eYSIP-2017/eYSIP-2017_Development-of-Tiva-based-daughter-board-for-FireBird/readme.txt

This folder contains the work done on Tiva based daughter board.
It includes manuals, experiment codes, schematics, report etc.
