eYSIP-2017/eYSIP-2017_Development-of-Tiva-based-daughter-board-for-FireBird/Schematic/Version 2/Readme.txt

The version 2 of uC based board is not routed. The sechmatic is changed as per requirement. The components are placed in their respective postions. 
Only the routing part is left.

The version 2 of Plug and Play board is fully completed.
