eYSIP-2017/eYSIP-2017_Development-of-Tiva-based-daughter-board-for-FireBird/report_eYSIP/report_eYSIP.pdf

## eYSIP2017

### Tiva Based Daughter Board

For Firebird V.

### Ayush Gaurav

Nagesh K.

### Piyush Manavar Saurav Shandilya Duration of Internship: 22/05/2017 − 07/07/2017

2017, e-Yantra Publication

# Tiva Based Daughter Board For

Firebird V.

## Abstract

The objective of the project was to design two daughter boards for firebird V which has following features:

- Compatible With TIVA based platform.
- must support all the necessary features of firebird.

The deliverables expected were

- 2 working daughter boards one with tiva launch pad and another with the Tiva TM4C123GH6PM.
- Hardware and software manual for anyone using it in future.
- All the demo codes for assistance.

### Completion status

The project was divided in many small tasks which were to be completed in given time. Though we refrain from mentioning that long list but still will give some important one.

- Learning Tiva Platform.
- Finding solution for limitations offered by Tiva, like limited GPIO pins and limited ADC channels.
- Utilizing the functionality provided to the maximum.
- Creating schematic and layout for the daughter boards.

1

1.1. HARDWARE PARTS
- Testing the boards and writing all the test codes.
- Making hardware and software manuals.

## 1.1 Hardware parts

- List of hardware used :

– Tiva launchpad.

– TM4C123GH6PM.

– MCP23017 port expander.

– ADC128D818 external adc.

– Voltage regulator(lm1117,7805).

- Detail of each hardware:
1. Tiva Launchpad: It is a micro-controller board by Texas Instruments that has on board programmer with real time debugger feature. The micro-controller is very efficient with system clock up to 80MHz and CAN protocol. The tutorial and more information can be read from Datasheet,,
2. TM4C123GH6PM is a ARM cortex M4 based micro-controller that is used as a controller of the Tiva Launchpad. You can read Datasheet for more details.
3. Voltage Regulators:The voltage source available on the Firebird is 9.6V. But the TIVA platform works on 3.3V and the servos can operate upto 6V. So there must be 3 different voltage levels on the board. The uC based board has 2 voltage regulators and the plug and play board has 1 voltage regulator. In the uC based board the 9.6 volts is regulated 3.3V to power the micro-controller. In the plug and play board the there is an inbuilt voltage regulator, so it is directly connected connected to 5v, 300mA source. The servo in both the boards has a separate 5V regulator. Datasheets for3.3 volts regulator lm1117, and 5 volts regulator 7805 5 volts regulator can be accessed from the links,
4. Level Converters TIVA platform operates at 3.3V and the Firebird operates at 5V. Directly connecting these pins to the TIVA may be fatal. So to for proper level maintenance, a level converter is used. A bidirectional MOS- FET based level converter used.
www.e-yantra.org | 2

1.2. SOFTWARE USED

The level converter is necessary is for input pins. In the boards Level converter is used for interfacing the position encoders of the motors. Datasheet of MOSFET is also provided.

5. Port Expander(MCP23017):TM4C123GH6PM has only 64 pins out which only 43 are GPIO pins. This limits our application to read input and respond correspondingly. To increase the number of GPIO and there interrupts we have used I2C compatible a port expander MCP23017. It has 2 PORTS A and B, with each port having 8 Pins.The interrupts on each pin can also be monitored. To read more about it, download the datasheet from here.The schematic of the connection is shown below.Keep in mind that I2C SCL and SDA have already been pulled up using 10K resistor.Datasheet of the port expander can be fount here.
- Connection diagram

## 1.2 Software used

- Code Composer Studio
- Detail of software: version, 7.1.0 download link, (http://processors.wiki.ti.com/index.php/Download_CCS)
- Installation steps

## 1.3 Assembly of hardware

Circuit diagram and m,¿Steps of assembly of hardware with pictures for each step

### Circuit Diagram

Circuit schematic, simplified circuit diagram , block diagram of system

### Step 1

Steps for assembling part 1

### Step 2

Steps for assembling part 2

www.e-yantra.org | 3

1.4. SOFTWARE AND CODE

### Step 3

Steps for assembling part 3

## 1.4 Software and Code

Github link (http://www.github.com) for the repository of code
Brief explanation of various parts of code

## 1.5 Use and Demo

Final Setup Image
User Instruction for demonstration Youtube Link (http://www.youtube.com) of demonstration video

## 1.6 Future Work

What can be done to take this work ahead in future as projects.

## 1.7 Bug report and Challenges

Any issues in code and hardware.
Any failure or challenges faced during project
www.e-yantra.org | 4

# Bibliography

[1] Ad Kamerman and Leo Monteban, WaveLAN-II: A High-Performance Wireless LAN for the Unlicensed band, 1997.

5
