eYSIP-2017/eYSIP-2017_Development-of-Tiva-based-daughter-board-for-FireBird/Documents/Progress Presentation I/Progress-Presentation.pdf

Overview of Project Overview of Task Overview of Task Task Accomplised Pin Assignment Pin Assignment Pin Assignment Pin Assignment Schematic Schematic Layout Layout Challenges Faced Future Plans Thank You

# Progress Presentation-I

# e-Yantra Summer Intership-2016 Tiva based Daughter Board For Firebird V

# Ayush Gaurav Nagesh K Mentors: Piyush Manavar Saurav Shandilya

## IIT Bombay

# June 9, 2017

Ayush Gaurav Nagesh K Mentors: Piyush Manavar Saurav Shandilya | IIT Bombay

Progress Presentation-I

# Overview of Project

Project Name: Tiva based Daughter Board For Firebird V.

# Objective: To design and develop a daughter board for firebird V with the following criterion:

1 | Tiva Based Platform.
2 | On board Programing facility.
3 | Direct compatibility to Firebird.

# Deliverables:

1 | Final schematic.
| Launchpad based daughter board TM4C123GH6PM based daughter board
2 | Working daughter board.
3 | Working codes for I/O, PWM, position encoders, lcd, wired and
| wireless communication, ADC.

# Overview of Task

Task | Deadline | Status
Understaing daughter board. List the pins of daughter board. Familiarize with Tiva C series Launchpad. | 3 days | Completed
Finalize the platform to design | 3 days | Completed
Design the schematic. Check compatibality with Firebird. | 2 days | Completed

# Overview of Task

Task | Deadline | Status
Discuss and add the necessary features to achieve maximum functionality. | 3 days | completed
Finalize the schematic. | 1 day | completed

# Task Accomplised

# Familiarization with Tiva Launchpad. Interfaced the following:

# GPIO

Timers and its interrupts.
External interrupts.
Pulse Width Modulation.
UART and its interrupts.

# Wired and wireless

Analog to digital converter.
LCD.
Studied the circuits to run the micro-controller. Analyzing the pins of firebird.
Assigning the pins of uC.
designing the schematics.

# Pin Assignment of uC based board


# Pin Assignment of uC based board


# Pin Assignment of launchpad based board

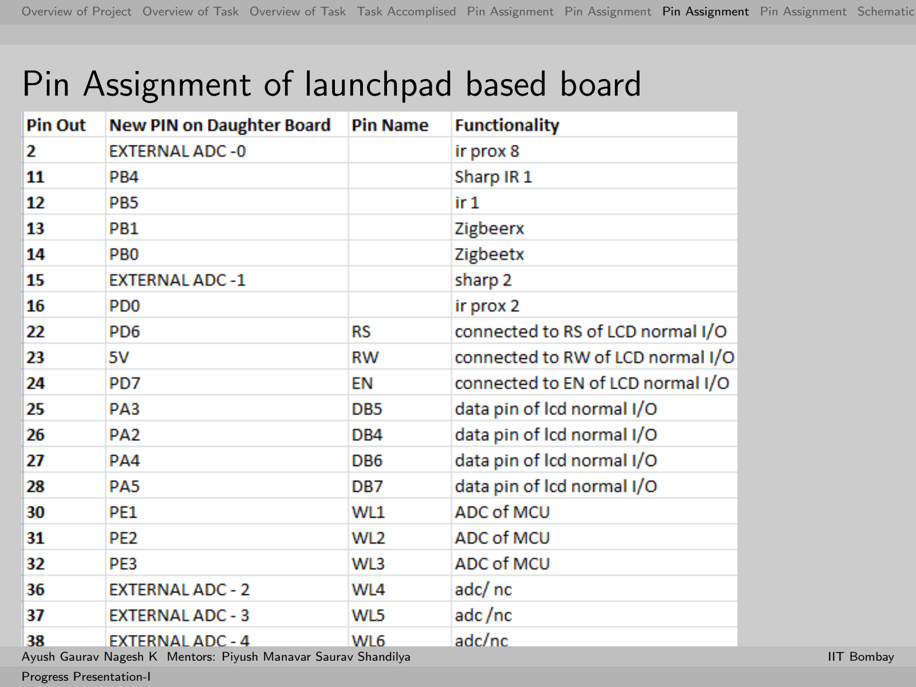
[picture p35: page 8]

# Pin Assignment of launchpad based board


# Schematic of uC based board


# Schematic of launchpad based board


# Layout of launchpad based board

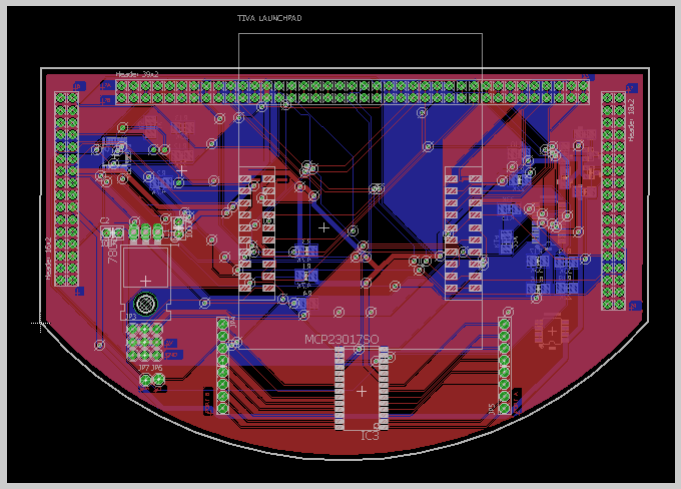
[picture p36: figure]

# Layout of uC based board


# Challenges Faced

Voltage incompatibility.
Pin availability.

# number of sensors on firebird

Nonavailability of firmware to program the board. Interfacing 5V compatible sensors with 3.3V compatible uC. Separate power supply for servo motors.

# Future Plans

Working Daughter board in next 2 weeks.
All the working codes.
Proper hardware manual by the end of the internship period.

# Thank You

# THANK YOU !!!
