eYSIP-2017/eYSIP-2017_Development-of-Tiva-based-daughter-board-for-FireBird/Sheet/schematic 2.xlsx

PA | PB |  | PC | PD | PE | PF
2 | 4 |  | 4 | 0 | 1 | 2
3 | 5 |  | 5 | 1 | 2 | 3
4 | 1 |  | 6 | 2 | 3 | 0 |  | free pins
5 | 0 |  |  | 3 | 4 | 1
6 | 3 |  |  |  | 5 | 4 |  | PF1 | SERVO
7 |  |  |  |  | 0 |  |  | PB6 | SERVO
 |  |  |  |  |  |  |  | PB7 | SERVO
 |  |  |  |  |  |  |  | PC7 | Interrupt for port expander
PA | PB |  | PC | PD | PE | PF |  | PA6 | I2C
2 | 0 |  | 4 | 0 | 0 | 0 |  | PA7 | I2C
3 | 1 |  | 5 | 1 | 1 | 1
4 | 3 |  | 6 | 2 | 2 | 2
5 | 4 |  |  | 3 | 3 | 3
6 | 5 |  |  |  | 4 | 4
7 |  |  |  |  | 5
 |  |  |  |  |  |  | channel | EXTERNAL ADC
 |  |  |  |  |  |  | 0 | ir prox 8
Connections: |  |  |  |  |  |  | 1 | sharp 2
1 | No |  | Current sensor |  |  |  | 2 | WL4
2 | EXTERNAL ADC -0 |  | ir prox 8 |  |  |  | 3 | WL5
3 |  |  | ground |  |  |  | 4 | WL6
4 | will use the inbuilt micro USB |  | DATA+ |  |  |  | 5 | WL7
5 | will use the inbuilt micro USB |  | DATA- |  |  |  | 6 | sharp sensor 4
6 |  |  | VCC USB |  |  |  | 7 | IR Prox6
7 |  |  | 5V(400mA)
8 |  |  | 5v 300mA
9 |  |  | 5v 300mA
10 |  |  | 5v 400ma
11 | PB4 |  | Sharp IR 1
12 | PB5 |  | ir 1
13 | PB1 |  | Zigbeerx
14 | PB0 |  | Zigbeetx
15 | EXTERNAL ADC -1 |  | sharp 2
16 | PD0 |  | ir prox 2
17 |  | RSSI | Connected to interrupt, Receive Strengh Signal, Can Measure Distance(DOUBTFUL an led)
18 |  | MOSI | MOSI of the Controller/NC create extra expansion headers
19 |  | MISO | MISO of controller/NC create extra expansion headers
20 |  | SCK | SCK of the controller/NC create extra expansion headers
21 |  | SSI | SS of the controller/ NC create extra expansion headers
22 | PD6 | RS | connected to RS of LCD normal I/O
23 | GND | RW | connected to RW of LCD normal I/O
24 | PD7 | EN | connected to EN of LCD normal I/O
25 | PA3 | DB5 | data pin of lcd normal I/O
26 | PA2 | DB4 | data pin of lcd normal I/O
27 | PA4 | DB6 | data pin of lcd normal I/O
28 | PA5 | DB7 | data pin of lcd normal I/O
29 |  | V Battery System | ADC to check the level of battery voltage
30 | PE1 | WL1 | ADC of MCU
31 | PE2 | WL2 | ADC of MCU
32 | PE3 | WL3 | ADC of MCU
33
34
35 |  | 5V
36 | EXTERNAL ADC - 2 | WL4 | adc/ nc
37 | EXTERNAL ADC - 3 | WL5 | adc /nc
38 | EXTERNAL ADC - 4 | WL6 | adc/nc
39 | EXTERNAL ADC - 5 | WL7 | adc/nc
40
41 | PD2 | Sharp Sensor 3 | ADC
42 | PD3 | IR prox 3 | ADC
43 | PD1 | IR prox 4 | ADC
44 | EXTERNAL ADC - 6 | sharp sensor 4 | ADC
45 | PE4 | sharp sensor 5 | ADC
46 | PE5 | ir prox 5 | ADC
47 |  | C11 motor | not present
48 |  | C1 PWM | not present
49 |  | c12 | not present
50 | PF2 | PWM L | left motor PWM(timer pin in PWM mode)
51 | PF3 | L1 | left motor pin1 normal I/O
52 | PB3 | L2 | left motor pin2 normal I/O
53 | PC4 | R1 | right motor pin1 normal I/O
54 | PC5 | PWM R2 | right motor PWM(timer pin in PWM mode)
55 | PC6 | R2 | right motor pin2
56 |  | NC
57 |  | NC
58 |  | NC
59 |  | NC
60 |  | NC
61 |  | NC
62 | PB2 | Position encoder left | int
63 | PF0 | Position encoder right | int
64 |  | position enocder C2 | int NC
65 |  | Position encoder C1 | int NC
66 |  | C22 | NC
67 |  | C21 | NC
68 |  | C2Pwm | NC
69 | EXTERNAL ADC - 7 | IR Prox6 | ADC
70 | PE0 | IR Prox7 | ADC
71 | PF4 | Buzzer | normal I/O pin
72 |  | DAC Out | NC
73 |  | RS232 TX | TX of UART
74 |  | RS232 RX | RX of UART
