eYSIP-2017/eYSIP-2017_Development-of-Tiva-based-daughter-board-for-FireBird/Daughter Board Manual/Hardware/Images/3v3Sensors.PNG

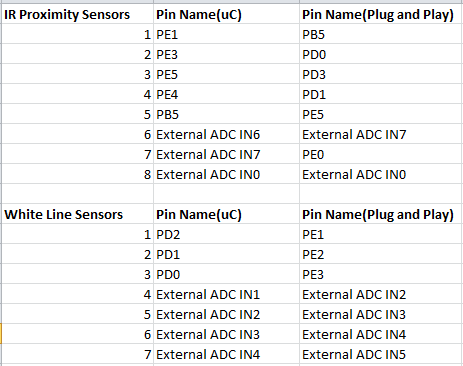
Daughter Board Manual/Hardware/Images/3v3Sensors.PNG
