eYSIP-2017/eYSIP-2017_Development-of-Tiva-based-daughter-board-for-FireBird/Daughter Board Manual/Hardware/Images/ADC.PNG

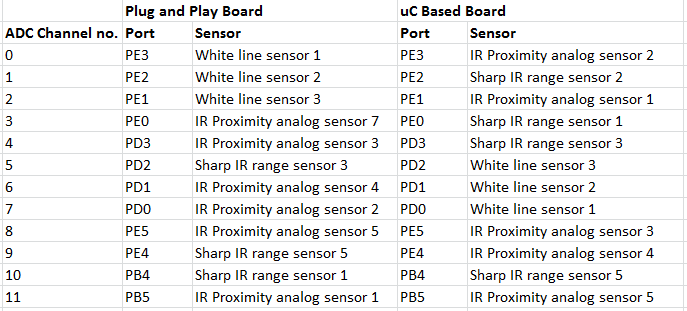
Daughter Board Manual/Hardware/Images/ADC.PNG
