eYSIP-2017/eYSIP-2017_Development-of-Tiva-based-daughter-board-for-FireBird/Documents/Poster/TIVA.png

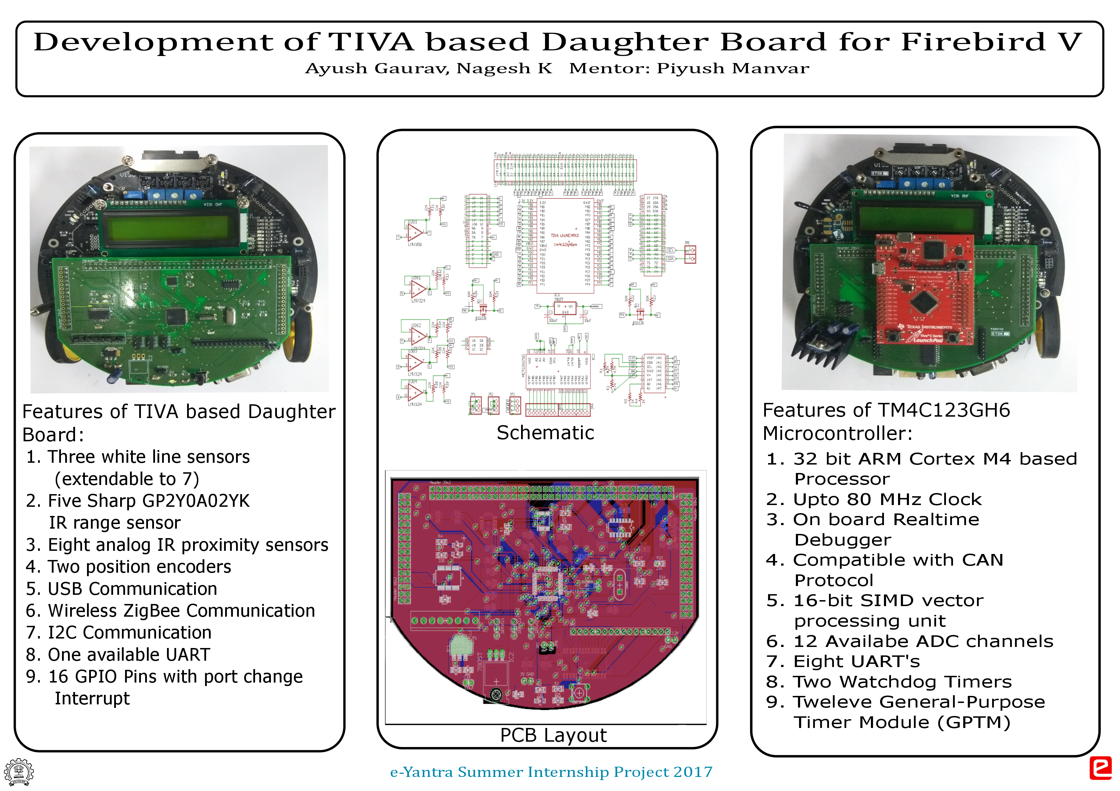
Documents/Poster/TIVA.png
