eYSIP-2017/eYSIP-2017_Development-of-Tiva-based-daughter-board-for-FireBird/report_eYSIP/Images/E4.PNG

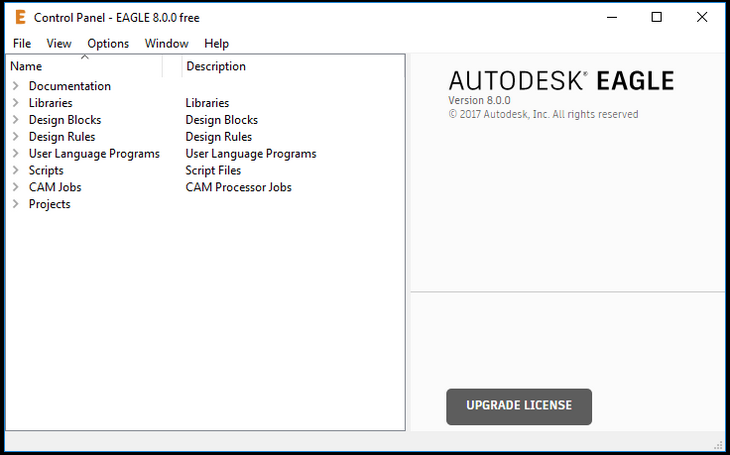
report_eYSIP/Images/E4.PNG
