eYSIP-2017/eYSIP-2017_Development-of-Tiva-based-daughter-board-for-FireBird/Daughter Board Manual/readme.txt

This folder contains hardware and software manual for daughter board.
