eYSIP-2017/eYSIP-2017_Development-of-Tiva-based-daughter-board-for-FireBird/Experiment/Plug And Play/Readme.txt

This folder contains example codes for Plug and Play Board.

All these codes are compiled in Code Composer Studio version 7.1.0 on Windows 10 Operating System.
