eYSIP-2017/eYSIP-2017_Development-of-Tiva-based-daughter-board-for-FireBird/Experiment/uC Based/Readme.txt

This folder contains example codes for uC based Board.

All these codes are compiled in Code Composer Studio version 7.1.0 on Windows 10 Operating System.
