eYSIP-2017/eYSIP-2017_Development-of-Tiva-based-daughter-board-for-FireBird/Schematic/Version 2/Uc/uC.brd

## EAGLE design Schematic/Version 2/Uc/uC.brd (2017-07-04)

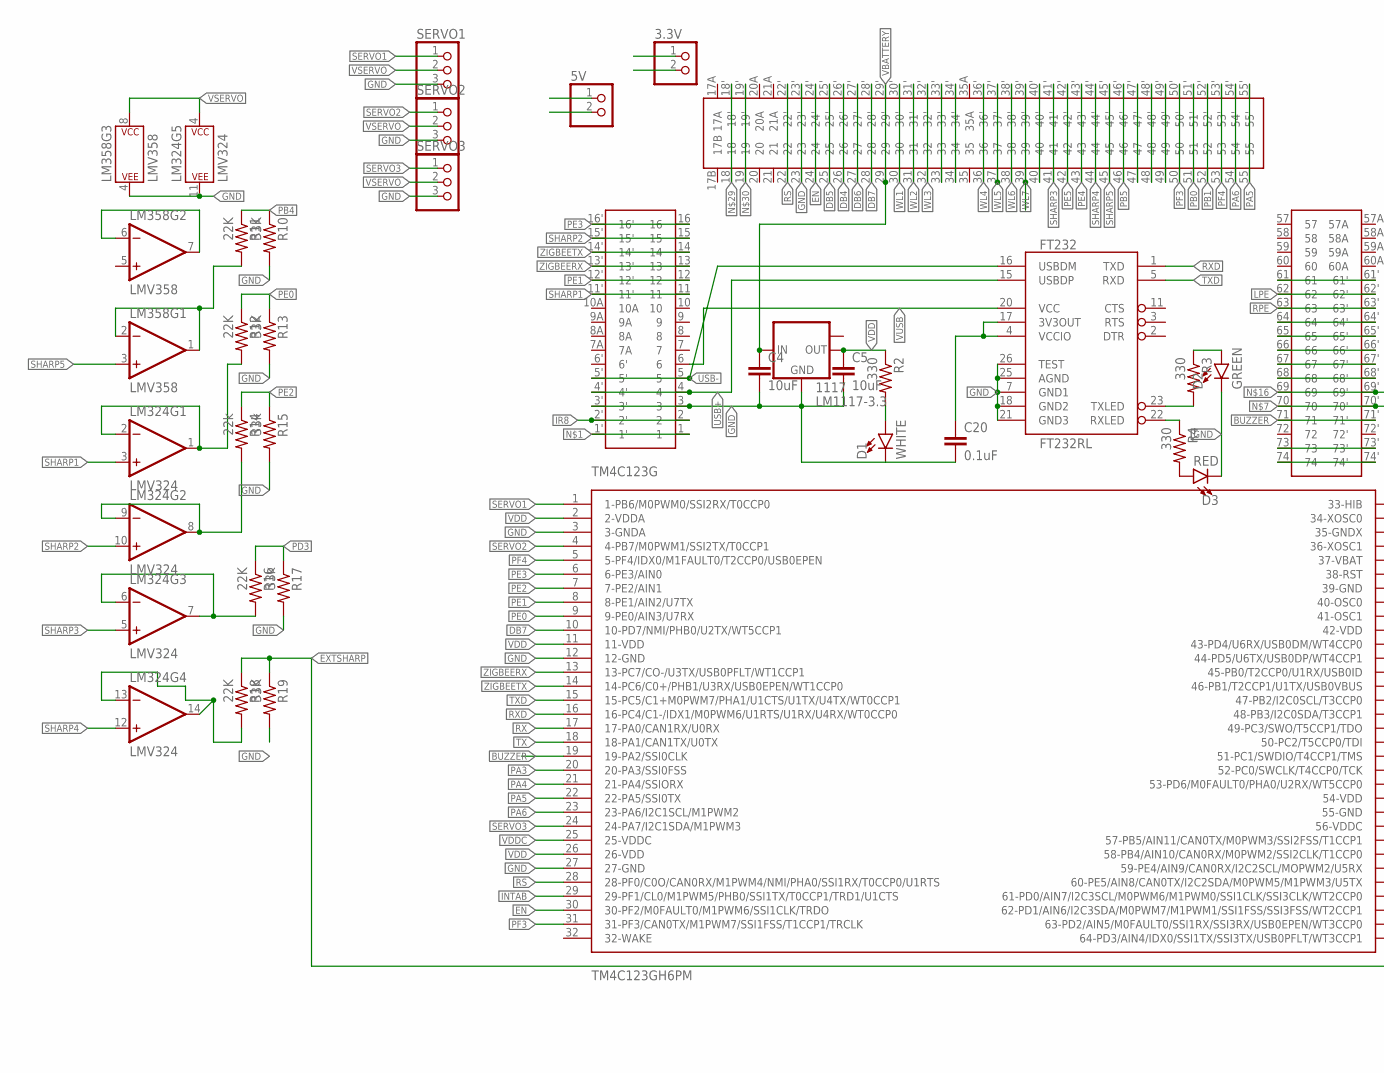
[picture p80: schematic uC.sch, part in row 1, column 1]

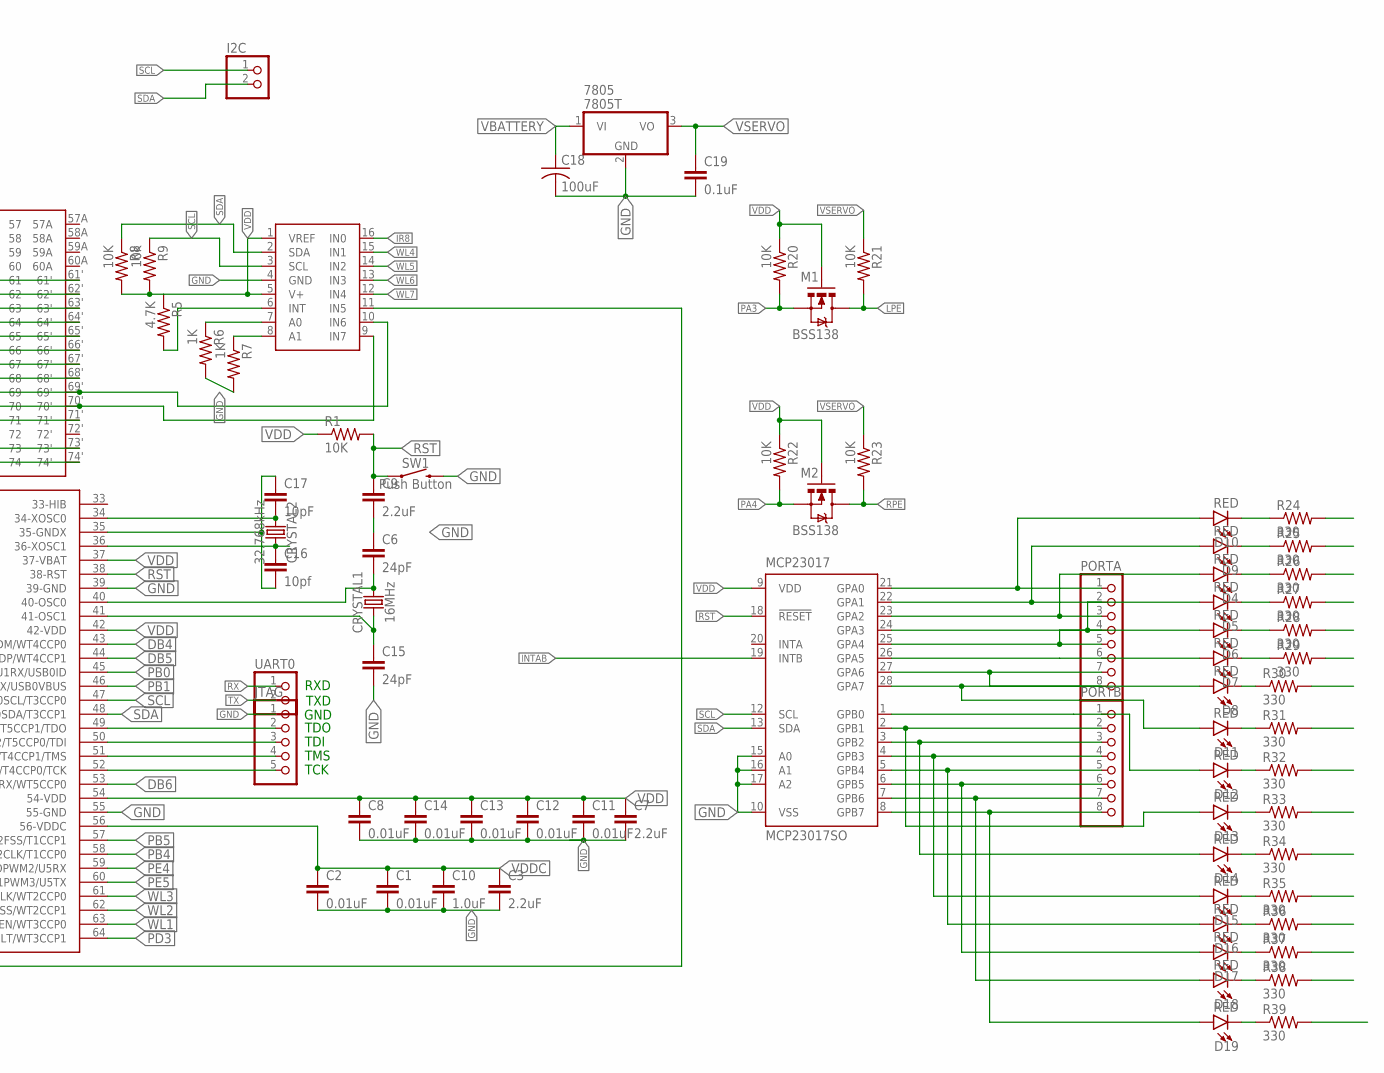
[picture p81: schematic uC.sch, part in row 1, column 2]

Parts:
3.3V, 5V: PINHD-1X2; 1X02
1117: LM1117-3.3; SOT223
7805: 7805T; TO220H
ADC128D818: ADC128D818; ADC12_SD
C1, C2, C8, C11, C12, C13, C14: 0.01uF; 1206
C3, C7, C9: 2.2uF; 1206
C4, C5: 10uF; 1206
C6, C15: 24pF; 1206
C10: 1.0uF; 1206
C16: 10pf; 1206
C17: 10pF; 1206
C18: 100uF; C025-024X044
C19, C20: 0.1uF; 1206
CRYSTAL1: 16MHz; HC49US
CRYSTAL2: 32.768kHz; CRYSTAL-PTH-2X6-CYL
D1: WHITE; LED-1206
D2: GREEN; LED-1206
D3, D4, D5, D6, D7, D8, D9, D10, D11, D12, D13, D14, D15, D16, D17, D18, D19: RED; LED-1206
FT232: FT232RL; SSOP28DB
I2C: PINHD-1X2; 1X02
JTAG: PINHD-1X5_2.54; 1X05
LM324: LMV324; SO14
LM358: LMV358; SO08
M1, M2: BSS138; SOT23-3
MCP23017: MCP23017SO; SO28W
PORTA: PINHD-1X8BIG; 1X08-BIG
PORTB: PINHD-1X8BIG; 1X08-BIG
R1, R8: 10K; M1206
R2, R3, R4, R24, R25, R26, R27, R28, R29, R30, R31, R32, R33, R34, R35, R36, R37, R38, R39: 330; M1206
R5: 4.7K; M1206
R6, R7: 1K; M1206
R9: 10k; M1206
R10, R13, R19: 33K; M1206
R11, R12, R16, R18: 22K; M1206
R14: 22k; M1206
R15, R17: 33k; M1206
R20, R21, R22, R23: 10K; 1206
SERVO1, SERVO2, SERVO3: PINHD-1X3; 1X03
SW1: Push Button; TACTILE_SWITCH_PTH_6.0MM
TM4C123G: TM4C123GH6PM; LQFP
U$1: DAUGHTERBOARDDAUGHTERBOARD; DAUGHTERBOARD
UART0: PINHD-1X2; 1X02

Connections:
BUZZER: TM4C123G.19 (19-PA2/SSI0CLK), U$1.71, U$1.71'
DB4: TM4C123G.43 (43-PD4/U6RX/USB0DM/WT4CCP0), U$1.26, U$1.26'
DB5: TM4C123G.44 (44-PD5/U6TX/USB0DP/WT4CCP1), U$1.25, U$1.25'
DB6: TM4C123G.53 (53-PD6/M0FAULT0/PHA0/U2RX/WT5CCP0), U$1.27, U$1.27'
DB7: TM4C123G.10 (10-PD7/NMI/PHB0/U2TX/WT5CCP1), U$1.28, U$1.28'
EN: TM4C123G.30 (30-PF2/M0FAULT0/M1PWM6/SSI1CLK/TRDO), U$1.24, U$1.24'
EXTSHARP: ADC128D818.11 (IN5), R18.1, R19.1
FDSFSDF: LM324.1 (OUT), LM324.2 (-IN), R12.2
GND: 3.3V.2, 5V.2, 1117.1 (GND), 7805.2 (GND), ADC128D818.4 (GND), C1.2, C2.2, C3.2, C4.2, C5.2, C6.1, C7.2, C8.2, C9.2, C10.2, C11.2, C12.2, C13.2, C14.2, C15.2, C18.2, C19.2, C20.2, D1.C, D2.C, D3.C, FT232.7 (GND1), FT232.18 (GND2), FT232.21 (GND3), FT232.25 (AGND), FT232.26 (TEST), JTAG.1, LM324.11 (P$V-), LM358.4 (P$V-), MCP23017.10 (VSS), MCP23017.15 (A0), MCP23017.16 (A1), MCP23017.17 (A2), R6.2, R7.2, R10.2, R13.2, R15.2, R17.2, R19.2, R24.2, R25.2, R26.2, R27.2, R28.2, R29.2, R30.2, R31.2, R32.2, R33.2, R34.2, R35.2, R36.2, R37.2, R38.2, R39.2, SERVO1.3, SERVO2.3, SERVO3.3, SW1.3 (2), TM4C123G.3 (3-GNDA), TM4C123G.12 (12-GND), TM4C123G.27 (27-GND), TM4C123G.39 (39-GND), TM4C123G.55 (55-GND), U$1.3, U$1.3', U$1.23, U$1.23'
GNDX: C16.2, C17.1, TM4C123G.35 (35-GNDX)
HGHJ: LM358.1 (OUT), LM358.2 (-IN), R11.2
INTAB: MCP23017.19 (INTB), TM4C123G.29 (29-PF1/CL0/M1PWM5/PHB0/SSI1TX/T0CCP1/TR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)
IR8: ADC128D818.16 (IN0), U$1.2, U$1.2'
LPE: M1.3 (D), R21.2, U$1.62, U$1.62'
unnamed: U$1.1, U$1.1'
unnamed: D10.A, MCP23017.21 (GPA0), PORTA.1
unnamed: C6.2, CRYSTAL1.2, TM4C123G.40 (40-OSC0)
unnamed: D9.A, MCP23017.22 (GPA1), PORTA.2
unnamed: LM358.6 (-IN), LM358.7 (OUT)
unnamed: ADC128D818.9 (IN7), U$1.70, U$1.70'
unnamed: D4.A, MCP23017.23 (GPA2), PORTA.3
unnamed: D5.A, MCP23017.24 (GPA3), PORTA.4
unnamed: D6.A, MCP23017.25 (GPA4), PORTA.5
unnamed: JTAG.5, TM4C123G.52 (52-PC0/SWCLK/T4CCP0/TCK)
unnamed: U$1.74, U$1.74'
unnamed: U$1.73, U$1.73'
unnamed: LM324.13 (-IN), LM324.14 (OUT), R18.2
unnamed: JTAG.4, TM4C123G.51 (51-PC1/SWDIO/T4CCP1/TMS)
unnamed: ADC128D818.10 (IN6), D10.C, R24.1, U$1.69, U$1.69'
unnamed: U$1.68, U$1.68'
unnamed: U$1.67, U$1.67'
unnamed: U$1.66, U$1.66'
unnamed: U$1.65, U$1.65'
unnamed: U$1.64, U$1.64'
unnamed: ADC128D818.7 (A0), R6.1
unnamed: D7.A, MCP23017.26 (GPA5), PORTA.6
unnamed: U$1.61, U$1.61'
unnamed: JTAG.3, TM4C123G.50 (50-PC2/T5CCP0/TDI)
unnamed: D1.A, R2.2
unnamed: C17.2, CRYSTAL2.1, TM4C123G.34 (34-XOSC0)
unnamed: C16.1, CRYSTAL2.2, TM4C123G.36 (36-XOSC1)
unnamed: D9.C, R25.1, U$1.18, U$1.18'
unnamed: D4.C, R26.1, U$1.19, U$1.19'
unnamed: JTAG.2, TM4C123G.49 (49-PC3/SWO/T5CCP1/TDO)
unnamed: D8.A, MCP23017.27 (GPA6), PORTA.7
unnamed: D11.A, MCP23017.28 (GPA7), PORTA.8
unnamed: D12.A, MCP23017.1 (GPB0), PORTB.1
unnamed: D13.A, MCP23017.2 (GPB1), PORTB.2
unnamed: D14.A, MCP23017.3 (GPB2), PORTB.3
unnamed: D15.A, MCP23017.4 (GPB3), PORTB.4
unnamed: D16.A, MCP23017.5 (GPB4), PORTB.5
unnamed: D17.A, MCP23017.6 (GPB5), PORTB.6
unnamed: D18.A, MCP23017.7 (GPB6), PORTB.7
unnamed: D19.A, MCP23017.8 (GPB7), PORTB.8
unnamed: U$1.33, U$1.33'
unnamed: U$1.34, U$1.34'
unnamed: D5.C, R27.1
unnamed: D6.C, R28.1
unnamed: D7.C, R29.1
unnamed: D8.C, R30.1
unnamed: U$1.40, U$1.40'
unnamed: D11.C, R31.1
unnamed: D12.C, R32.1
unnamed: D13.C, R33.1
unnamed: D19.C, R39.1
unnamed: D18.C, R38.1
unnamed: D17.C, R37.1
unnamed: U$1.47, U$1.47'
unnamed: U$1.48, U$1.48'
unnamed: U$1.49, U$1.49'
unnamed: D16.C, R36.1
unnamed: D15.C, R35.1
unnamed: D14.C, R34.1
unnamed: FT232.22 (RXLED), R4.1
unnamed: FT232.23 (TXLED), R3.2
unnamed: D3.A, R4.2
unnamed: D2.A, R3.1
unnamed: ADC128D818.6 (INT), R5.2
unnamed: ADC128D818.8 (A1), R7.1
unnamed: C20.1, FT232.4 (VCCIO), FT232.17 (3V3OUT)
NO: C15.1, CRYSTAL1.1, TM4C123G.41 (41-OSC1)
PA3: M1.2 (S), R20.2, TM4C123G.20 (20-PA3/SSI0FSS)
PA4: M2.2 (S), R22.2, TM4C123G.21 (21-PA4/SSIORX)
PA5: TM4C123G.22 (22-PA5/SSI0TX), U$1.55, U$1.55'
PA6: TM4C123G.23 (23-PA6/I2C1SCL/M1PWM2), U$1.54, U$1.54'
PB0: TM4C123G.45 (45-PB0/T2CCP0/U1RX/USB0ID), U$1.51, U$1.51'
PB1: TM4C123G.46 (46-PB1/T2CCP1/U1TX/USB0VBUS), U$1.52, U$1.52'
PB4: R10.1, R11.1, TM4C123G.58 (58-PB4/AIN10/CAN0RX/M0PWM2/SSI2CLK/T1CC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)
PB5: TM4C123G.57 (57-PB5/AIN11/CAN0TX/M0PWM3/SSI2FSS/T1CC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), U$1.46, U$1.46'
PD3: R16.1, R17.1, TM4C123G.64 (64-PD3/AIN4/IDX0/SSI1TX/SSI3TX/USB0PFLT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)
PE0: R12.1, R13.1, TM4C123G.9 (9-PE0/AIN3/U7RX)
PE1: TM4C123G.8 (8-PE1/AIN2/U7TX), U$1.12, U$1.12'
PE2: R14.1, R15.1, TM4C123G.7 (7-PE2/AIN1)
PE3: TM4C123G.6 (6-PE3/AIN0), U$1.16, U$1.16'
PE4: TM4C123G.59 (59-PE4/AIN9/CAN0RX/I2C2SCL/MOPWM2/U5RX), U$1.43, U$1.43'
PE5: TM4C123G.60 (60-PE5/AIN8/CAN0TX/I2C2SDA/M0PWM5/M1PWM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), U$1.42, U$1.42'
PF3: TM4C123G.31 (31-PF3/CAN0TX/M1PWM7/SSI1FSS/T1CCP1/TRC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), U$1.50, U$1.50'
PF4: TM4C123G.5 (5-PF4/IDX0/M1FAULT0/T2CCP0/USB0EPEN), U$1.53, U$1.53'
RPE: M2.3 (D), R23.2, U$1.63, U$1.63'
RS: TM4C123G.28 (28-PF0/C0O/CAN0RX/M1PWM4/NMI/PHA0/SSI1R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), U$1.22, U$1.22'
RST: C9.1, MCP23017.18 (!RESET), R1.2, SW1.1, TM4C123G.38 (38-RST)
RX: TM4C123G.17 (17-PA0/CAN1RX/U0RX), UART0.1
RXD: FT232.1 (TXD), TM4C123G.16 (16-PC4/C1-/IDX1/M0PWM6/U1RTS/U1RX/U4RX/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)
SCL: ADC128D818.3 (SCL), I2C.1, MCP23017.12 (SCL), R9.1, TM4C123G.47 (47-PB2/I2C0SCL/T3CCP0)
SDA: ADC128D818.2 (SDA), I2C.2, MCP23017.13 (SDA), R8.1, TM4C123G.48 (48-PB3/I2C0SDA/T3CCP1)
SDFSDFSD: LM324.8 (OUT), LM324.9 (-IN), R14.2
SERVO1: SERVO1.1, TM4C123G.1 (1-PB6/M0PWM0/SSI2RX/T0CCP0)
SERVO2: SERVO2.1, TM4C123G.4 (4-PB7/M0PWM1/SSI2TX/T0CCP1)
SERVO3: SERVO3.1, TM4C123G.24 (24-PA7/I2C1SDA/M1PWM3)
SHARP1: LM324.3 (+IN), U$1.11, U$1.11'
SHARP2: LM324.10 (+IN), U$1.15, U$1.15'
SHARP3: LM324.5 (+IN), U$1.41, U$1.41'
SHARP4: LM324.12 (+IN), U$1.44, U$1.44'
SHARP5: LM358.3 (+IN), U$1.45, U$1.45'
TX: TM4C123G.18 (18-PA1/CAN1TX/U0TX), UART0.2
TXD: FT232.5 (RXD), TM4C123G.15 (15-PC5/C1+M0PWM7/PHA1/U1CTS/U1TX/U4TX/W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)
USB+: FT232.15 (USBDP), U$1.4, U$1.4'
USB-: FT232.16 (USBDM), U$1.5, U$1.5'
VBATTERY: 1117.3 (IN), 7805.1 (VI), C4.1, C18.1, U$1.29, U$1.29'
VDD: 3.3V.1, 1117.2 (OUT), ADC128D818.1 (VREF), ADC128D818.5 (V+), C5.1, C7.1, C8.1, C11.1, C12.1, C13.1, C14.1, M1.1 (G), M2.1 (G), MCP23017.9 (VDD), R1.1, R2.1, R5.1, R8.2, R9.2, R20.1, R22.1, TM4C123G.2 (2-VDDA), TM4C123G.11 (11-VDD), TM4C123G.26 (26-VDD), TM4C123G.37 (37-VBAT), TM4C123G.42 (42-VDD), TM4C123G.54 (54-VDD)
VDDC: C1.1, C2.1, C3.1, C10.1, TM4C123G.25 (25-VDDC), TM4C123G.56 (56-VDDC)
VSERVO: 5V.1, 7805.3 (VO), C19.1, LM324.4 (P$V+), LM358.8 (P$V+), R21.1, R23.1, SERVO1.2, SERVO2.2, SERVO3.2
VUSB: FT232.20 (VCC), U$1.6
WL1: TM4C123G.63 (63-PD2/AIN5/M0FAULT0/SSI1RX/SSI3RX/USB0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), U$1.30, U$1.30'
WL2: TM4C123G.62 (62-PD1/AIN6/I2C3SDA/M0PWM7/M1PWM1/SSI1F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), U$1.31, U$1.31'
WL3: TM4C123G.61 (61-PD0/AIN7/I2C3SCL/M0PWM6/M1PWM0/SSI1C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), U$1.32, U$1.32'
WL4: ADC128D818.15 (IN1), U$1.36, U$1.36'
WL5: ADC128D818.14 (IN2), U$1.37, U$1.37'
WL6: ADC128D818.13 (IN3), U$1.38, U$1.38'
WL7: ADC128D818.12 (IN4), U$1.39, U$1.39'
XXVX: LM324.6 (-IN), LM324.7 (OUT), R16.2
ZIGBEERX: TM4C123G.13 (13-PC7/CO-/U3TX/USB0PFLT/WT1CCP1), U$1.13, U$1.13'
ZIGBEETX: TM4C123G.14 (14-PC6/C0+/PHB1/U3RX/USB0EPEN/WT1CCP0), U$1.14, U$1.14'

Notes on the sheet:
TCK
TMS
TDI
TDO
TXD
RXD
GND

Board: 2 copper layers, 102 parts (37 on the bottom side), 133 nets, no tracks yet.
