eYSIP-2017/eYSIP-2017_Development-of-Tiva-based-daughter-board-for-FireBird/Schematic/Version 2/Launchpad/Schematic-1.brd

## EAGLE design Schematic/Version 2/Launchpad/Schematic-1.brd (2017-07-04)

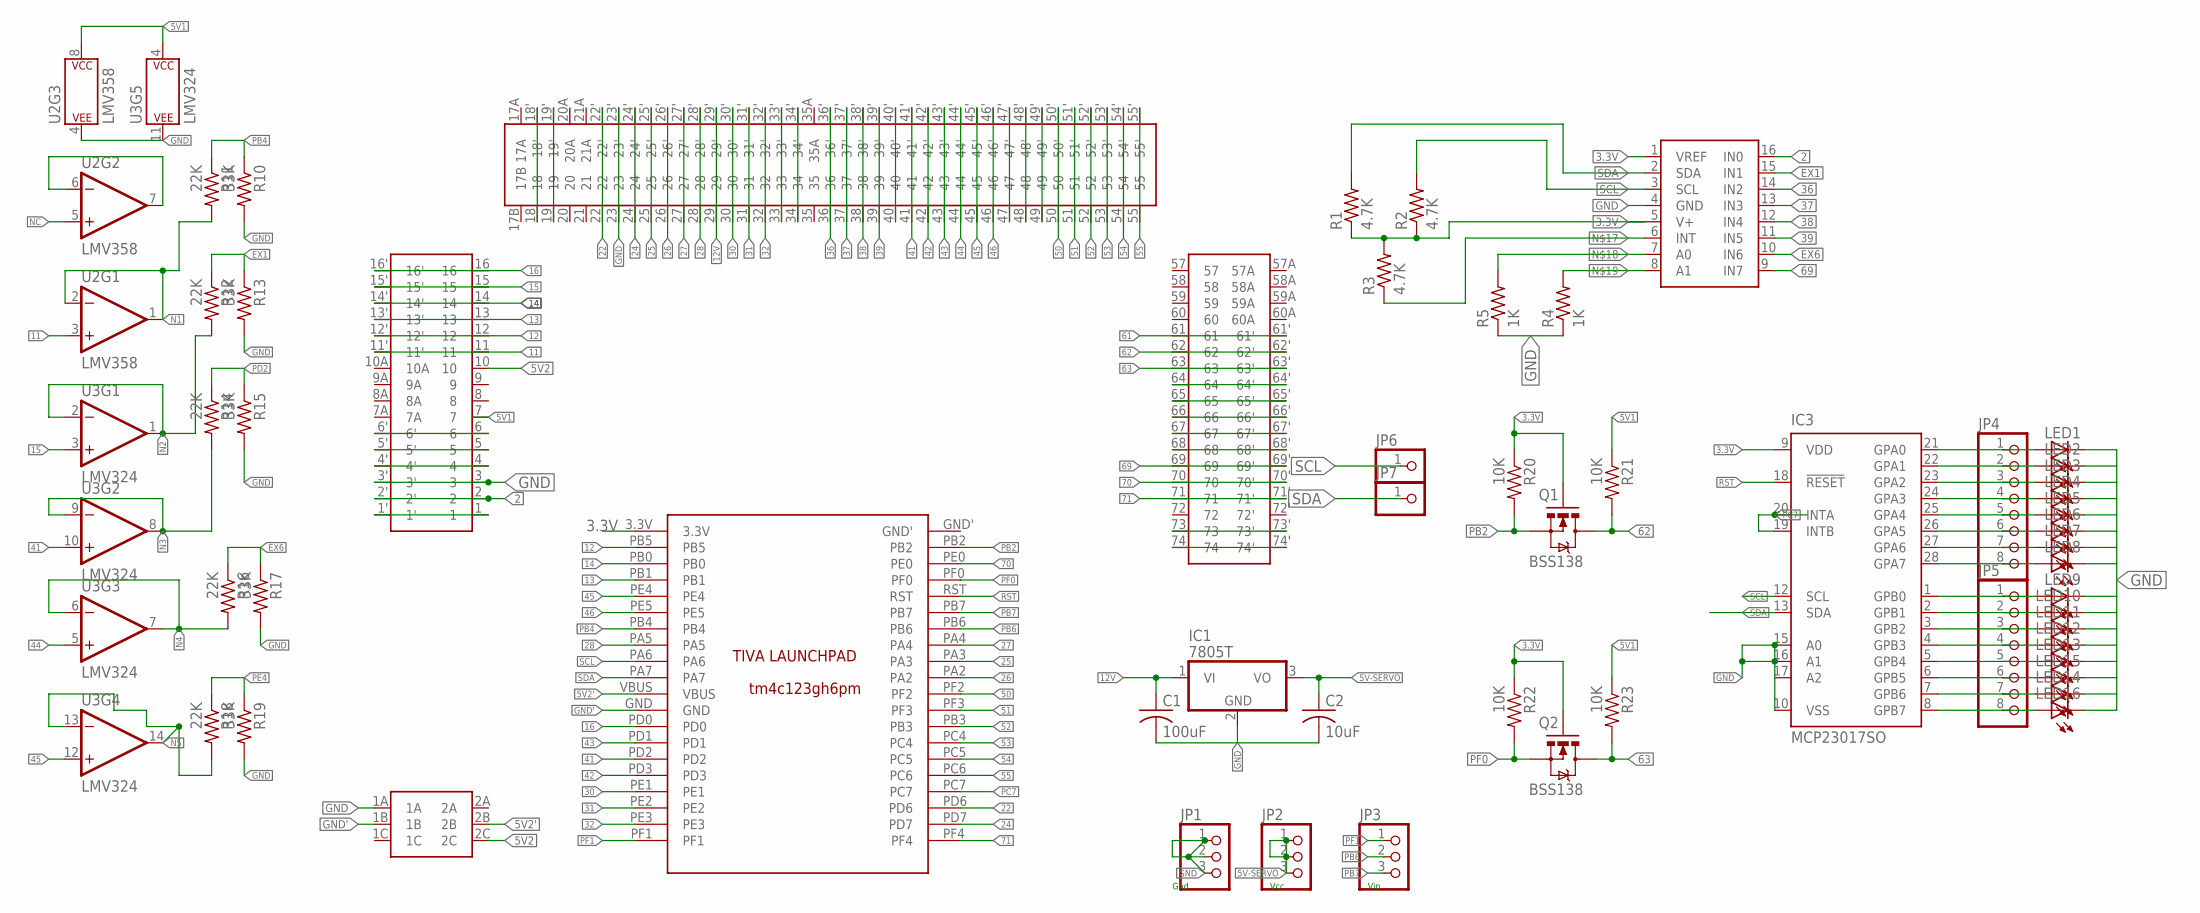
[picture p82: schematic Schematic-1.sch]

Parts:
C1: 100uF; C025-030X050
C2: 10uF; C025-030X050
IC1: 7805T; TO220H
IC3: MCP23017SO; SO28W
JP1, JP2, JP3: PINHD-1X3; 1X03
JP4, JP5: PINHD-1X8BIG; 1X08-BIG
JP6, JP7: PINHD-1X1; 1X01
LED1, LED2, LED3, LED4, LED5, LED6, LED7, LED8, LED9, LED10, LED11, LED12, LED13, LED14, LED15, LED16: LEDSMT1206; 1206
Q1, Q2: BSS138; SOT23-3
R1, R2, R3: 4.7K; M1206
R4, R5: 1K; M1206
R10, R13, R15, R17, R19: 33K; M1206
R11, R12, R14, R16, R18: 22K; M1206
R20, R21, R22, R23: 10K; 1206
U2: LMV358; SO08
U3: LMV324; SO14
U$1: DAUGHTERBOARDDAUGHTERBOARD; DAUGHTERBOARD
U$2: TIVA_LAUNCHPADTIVA_LAUNCHPAD; TIVA_LAUNCHPAD
U$3: SELF-LOCKING_SWITCHSELF-LOCKING_SWITCH; SELF-LOCKING_SWITCH
U$4: ADC128D818; ADC12_SD

Connections:
2: U$1.2, U$1.2', U$4.16 (IN0)
3.3V: IC3.9 (VDD), Q1.1 (G), Q2.1 (G), R1.1, R2.1, R3.2, R20.1, R22.1, U$2.3.3V, U$4.1 (VREF), U$4.5 (V+)
5V1: R21.1, R23.1, U2.8 (P$V+), U3.4 (P$V+), U$1.7
5V2: U$1.10, U$3.2C
5V2': U$2.VBUS, U$3.2B
5V-SERVO: C2.1, IC1.3 (VO), JP2.1, JP2.2, JP2.3
11: U2.3 (+IN), U$1.11, U$1.11'
12: U$1.12, U$1.12', U$2.PB5
12V: C1.1, IC1.1 (VI), U$1.29, U$1.29'
13: U$1.13, U$1.13', U$2.PB1
14: U$1.14, U$1.14', U$2.PB0
15: U3.3 (+IN), U$1.15, U$1.15'
16: U$1.16, U$1.16', U$2.PD0
22: U$1.22, U$1.22', U$2.PD6
24: U$1.24, U$1.24', U$2.PD7
25: U$1.25, U$1.25', U$2.PA3
26: U$1.26, U$1.26', U$2.PA2
27: U$1.27, U$1.27', U$2.PA4
28: U$1.28, U$1.28', U$2.PA5
30: U$1.30, U$1.30', U$2.PE1
31: U$1.31, U$1.31', U$2.PE2
32: U$1.32, U$1.32', U$2.PE3
36: U$1.36, U$1.36', U$4.14 (IN2)
37: U$1.37, U$1.37', U$4.13 (IN3)
38: U$1.38, U$1.38', U$4.12 (IN4)
39: U$1.39, U$1.39', U$4.11 (IN5)
41: U3.10 (+IN), U$1.41, U$1.41', U$2.PD2
42: U$1.42, U$1.42', U$2.PD3
43: U$1.43, U$1.43', U$2.PD1
44: U3.5 (+IN), U$1.44, U$1.44'
45: U3.12 (+IN), U$1.45, U$1.45', U$2.PE4
46: U$1.46, U$1.46', U$2.PE5
50: U$1.50, U$1.50', U$2.PF2
51: U$1.51, U$1.51', U$2.PF3
52: U$1.52, U$1.52', U$2.PB3
53: U$1.53, U$1.53', U$2.PC4
54: U$1.54, U$1.54', U$2.PC5
55: U$1.55, U$1.55', U$2.PC6
61: U$1.61, U$1.61'
62: Q1.3 (D), R21.2, U$1.62, U$1.62'
63: Q2.3 (D), R23.2, U$1.63, U$1.63'
69: U$1.69, U$1.69', U$4.9 (IN7)
70: U$1.70, U$1.70', U$2.PE0
71: U$1.71, U$1.71', U$2.PF4
EX1: R12.1, R13.1, U$4.15 (IN1)
EX6: R16.1, R17.1, U$4.10 (IN6)
GND: C1.2, C2.2, IC1.2 (GND), IC3.10 (VSS), IC3.15 (A0), IC3.16 (A1), IC3.17 (A2), JP1.1, JP1.2, JP1.3, LED1.C, LED2.C, LED3.C, LED4.C, LED5.C, LED6.C, LED7.C, LED8.C, LED9.C, LED10.C, LED11.C, LED12.C, LED13.C, LED14.C, LED15.C, LED16.C, R4.1, R5.1, R10.2, R13.2, R15.2, R17.2, R19.2, U2.4 (P$V-), U3.11 (P$V-), U$1.3, U$1.3', U$1.23, U$1.23', U$3.1A, U$4.4 (GND)
GND': U$2.GND, U$3.1B
N1: R11.2, U2.1 (OUT), U2.2 (-IN)
N2: R12.2, U3.1 (OUT), U3.2 (-IN)
N3: R14.2, U3.8 (OUT), U3.9 (-IN)
N4: R16.2, U3.6 (-IN), U3.7 (OUT)
N5: R18.2, U3.13 (-IN), U3.14 (OUT)
unnamed: U$1.1, U$1.1'
unnamed: U2.6 (-IN), U2.7 (OUT)
unnamed: IC3.21 (GPA0), JP4.1, LED1.A
unnamed: U$1.4, U$1.4'
unnamed: U$1.5, U$1.5'
unnamed: U$1.6, U$1.6'
unnamed: IC3.23 (GPA2), JP4.3, LED3.A
unnamed: IC3.24 (GPA3), JP4.4, LED4.A
unnamed: IC3.22 (GPA1), JP4.2, LED2.A
unnamed: IC3.25 (GPA4), JP4.5, LED5.A
unnamed: IC3.26 (GPA5), JP4.6, LED6.A
unnamed: IC3.27 (GPA6), JP4.7, LED7.A
unnamed: U$1.18, U$1.18'
unnamed: U$1.19, U$1.19'
unnamed: IC3.28 (GPA7), JP4.8, LED8.A
unnamed: R3.1, U$4.6 (INT)
unnamed: R5.2, U$4.7 (A0)
unnamed: R4.2, U$4.8 (A1)
unnamed: IC3.1 (GPB0), JP5.1, LED9.A
unnamed: IC3.2 (GPB1), JP5.2, LED10.A
unnamed: IC3.3 (GPB2), JP5.3, LED11.A
unnamed: IC3.4 (GPB3), JP5.4, LED12.A
unnamed: IC3.5 (GPB4), JP5.5, LED13.A
unnamed: IC3.6 (GPB5), JP5.6, LED15.A
unnamed: U$1.33, U$1.33'
unnamed: U$1.34, U$1.34'
unnamed: IC3.7 (GPB6), JP5.7, LED14.A
unnamed: IC3.8 (GPB7), JP5.8, LED16.A
unnamed: U$1.40, U$1.40'
unnamed: U$1.47, U$1.47'
unnamed: U$1.48, U$1.48'
unnamed: U$1.49, U$1.49'
unnamed: U$1.64, U$1.64'
unnamed: U$1.65, U$1.65'
unnamed: U$1.66, U$1.66'
unnamed: U$1.67, U$1.67'
unnamed: U$1.68, U$1.68'
unnamed: U$1.73, U$1.73'
unnamed: U$1.74, U$1.74'
NC: U2.5 (+IN)
PB2: Q1.2 (S), R20.2, U$2.PB2
PB4: R10.1, R11.1, U$2.PB4
PB6: JP3.2, U$2.PB6
PB7: JP3.3, U$2.PB7
PC7: IC3.19 (INTB), IC3.20 (INTA), U$2.PC7
PD2: R14.1, R15.1
PE4: R18.1, R19.1
PF0: Q2.2 (S), R22.2, U$2.PF0
PF1: JP3.1, U$2.PF1
RST: IC3.18 (!RESET), U$2.RST
SCL: IC3.12 (SCL), JP6.1, R2.2, U$2.PA6, U$4.3 (SCL)
SDA: IC3.13 (SDA), JP7.1, R1.2, U$2.PA7, U$4.2 (SDA)

Notes on the sheet:
Gnd
Vcc
Vin

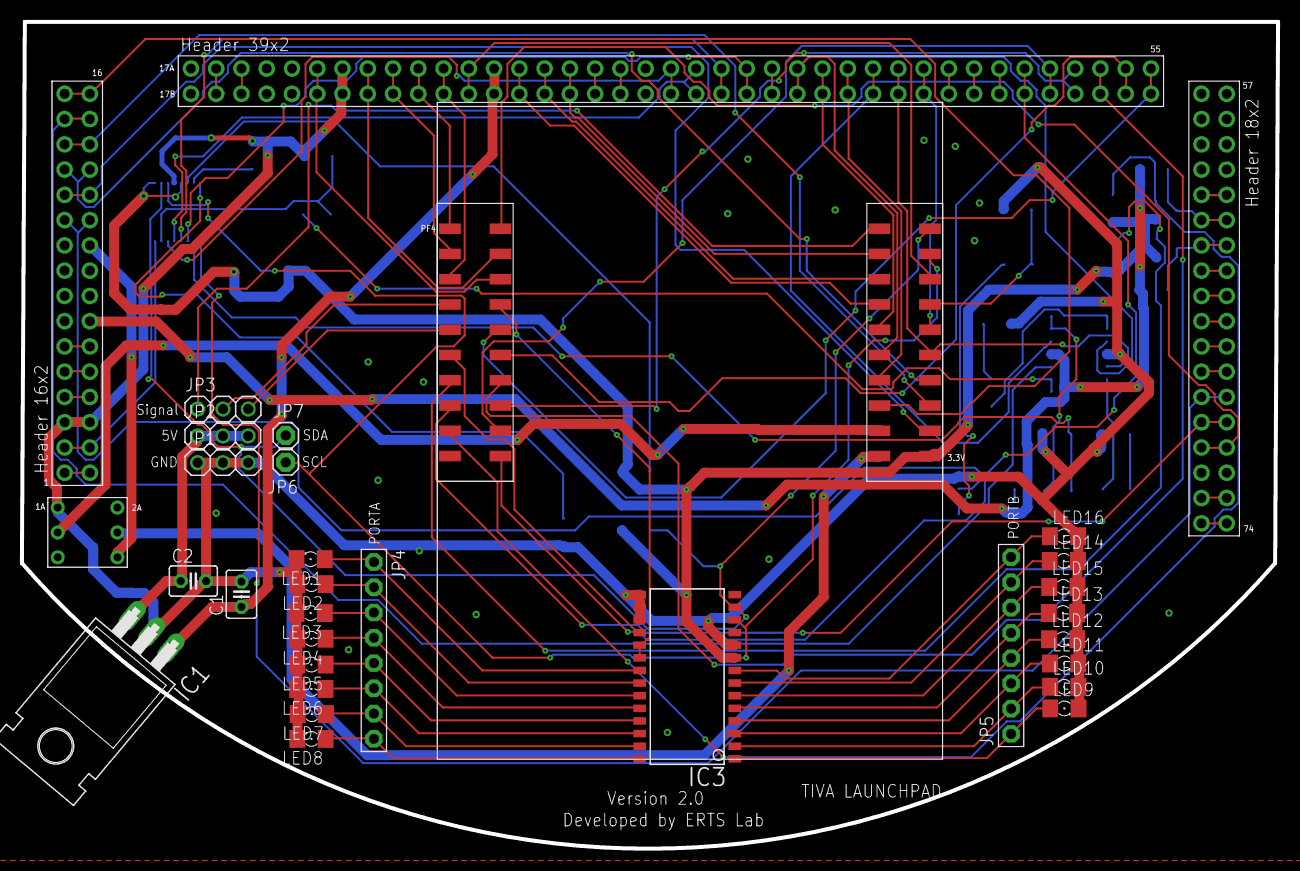
[picture p83: board Schematic-1.brd from above]

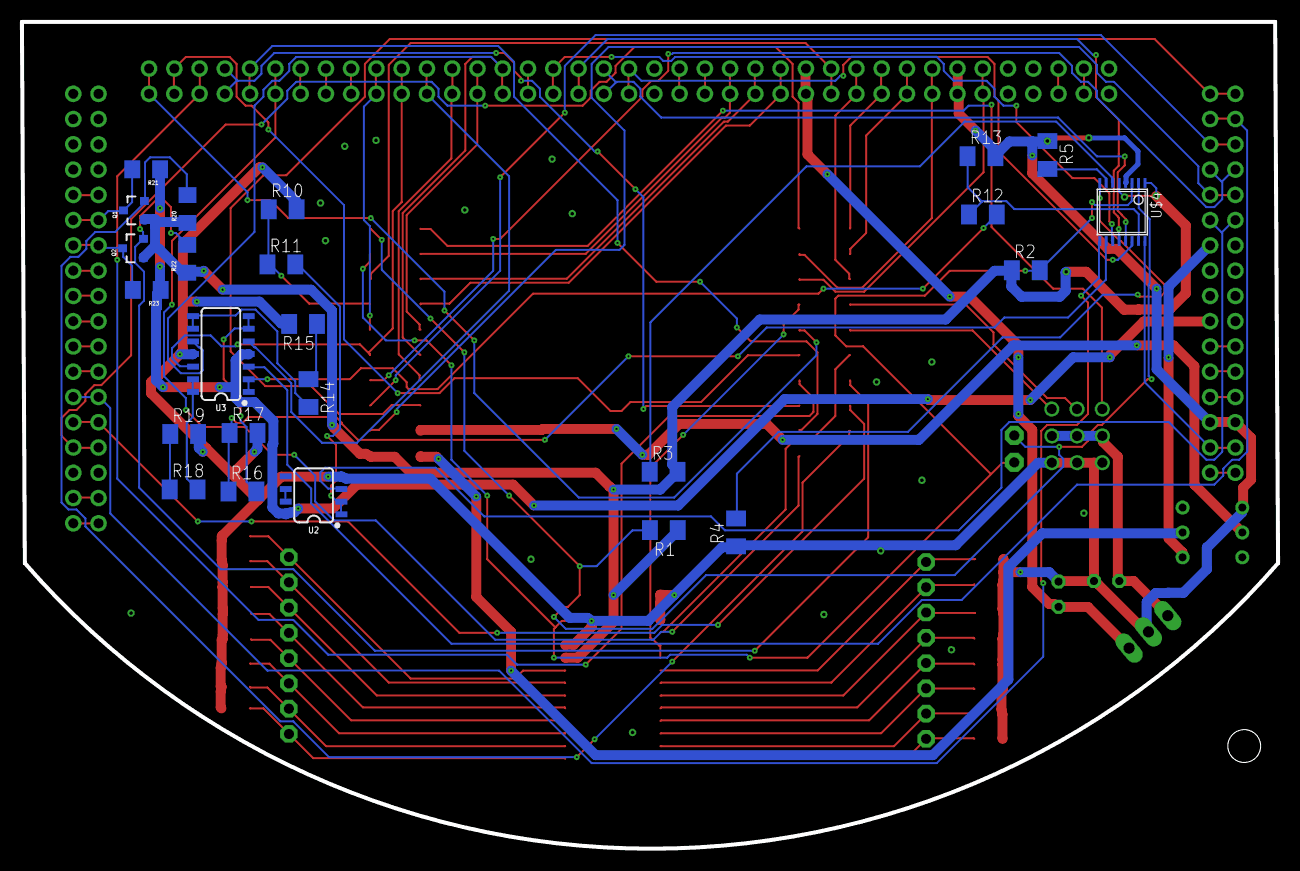
[picture p84: board Schematic-1.brd from below]

Board: 2 copper layers, 126.3 x 83.1 mm, 54 parts (24 on the bottom side), 104 nets.
