eYSIP-2017/eYSIP-2017_Development-of-Tiva-based-daughter-board-for-FireBird/Schematic/Version 1/uC/DBSchematics.brd

## EAGLE design Schematic/Version 1/uC/DBSchematics.brd (2017-06-16, an earlier design)

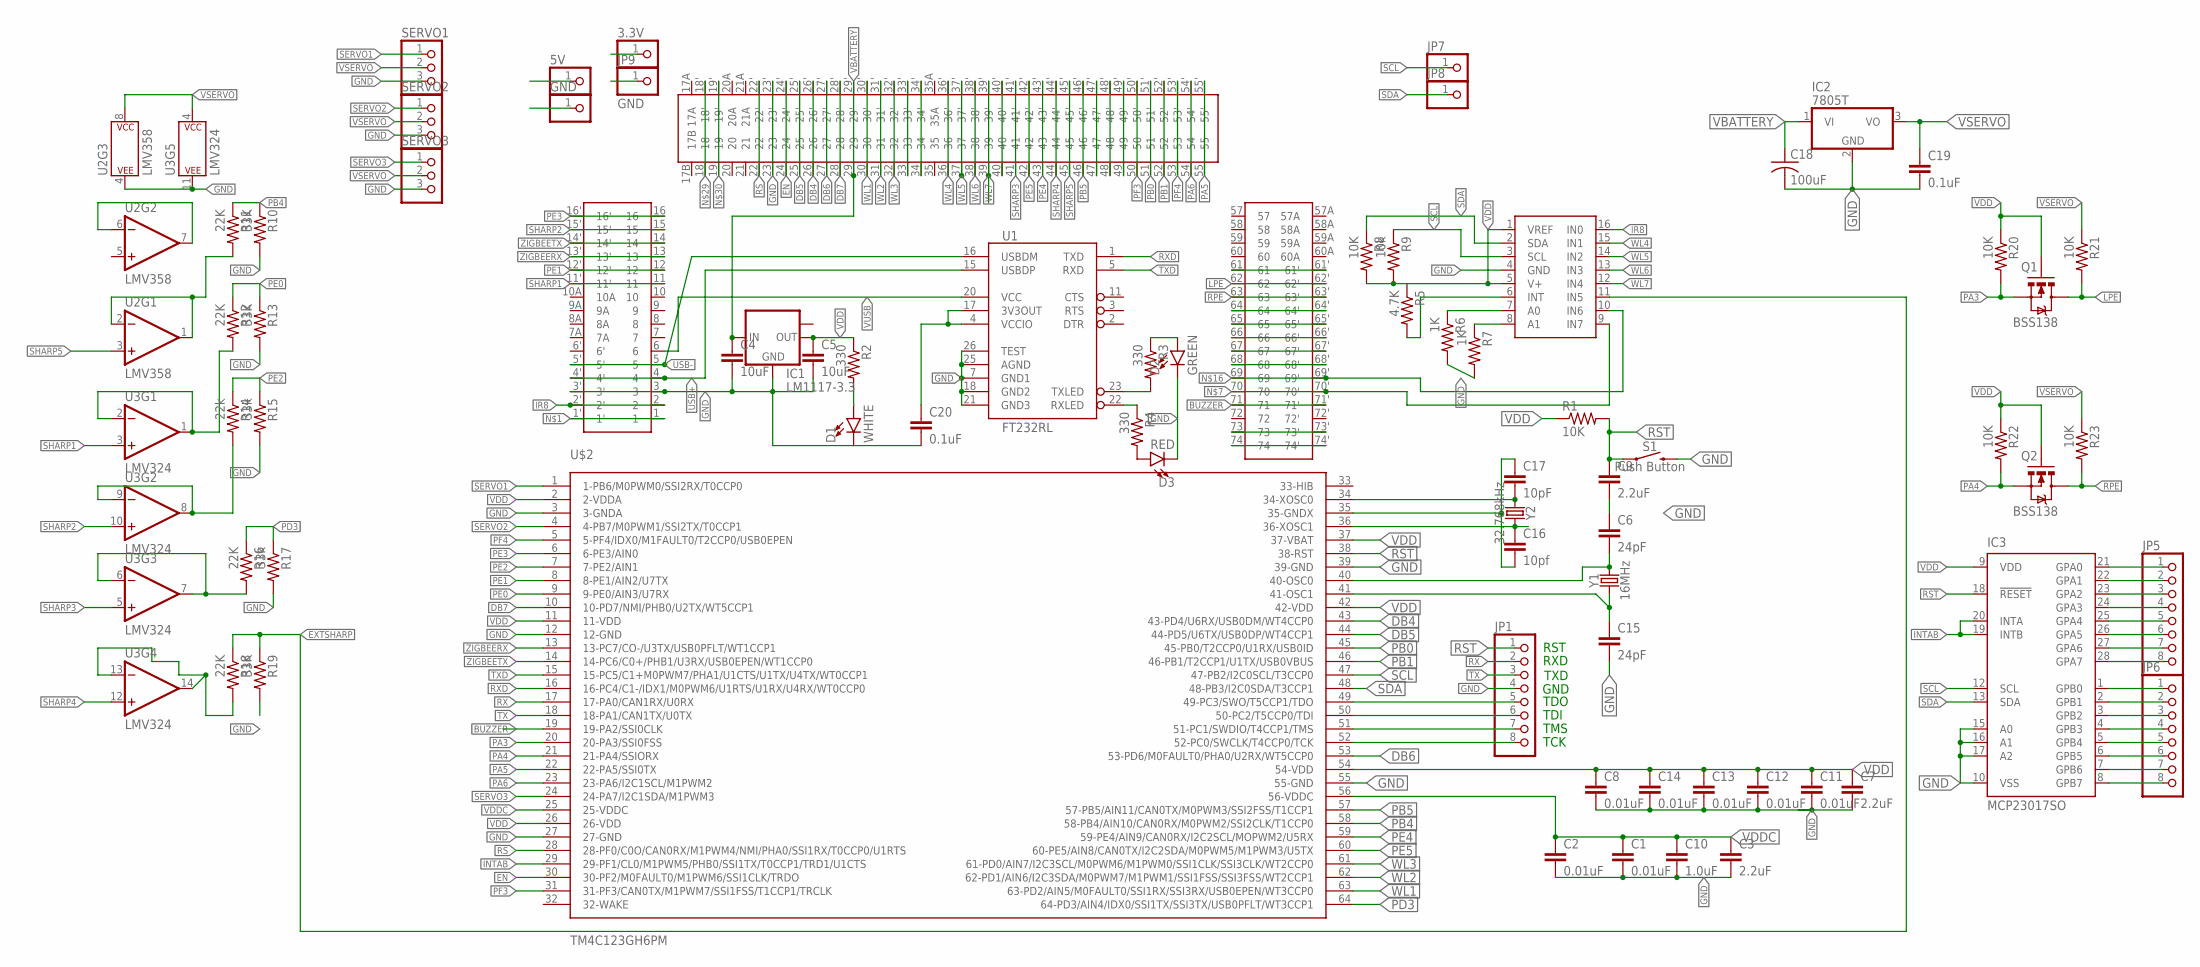
[picture p85: schematic DBSchematics.sch]

Parts:
3.3V, 5V: PINHD-1X1; 1X01
C1, C2, C8, C11, C12, C13, C14: 0.01uF; 1206
C3, C7, C9: 2.2uF; 1206
C4, C5: 10uF; 1206
C6, C15: 24pF; 1206
C10: 1.0uF; 1206
C16: 10pf; 1206
C17: 10pF; 1206
C18: 100uF; C025-024X044
C19, C20: 0.1uF; 1206
D1: WHITE; LED-1206
D2: GREEN; LED-1206
D3: RED; LED-1206
GND: PINHD-1X1; 1X01
IC1: LM1117-3.3; SOT223
IC2: 7805T; TO220H
IC3: MCP23017SO; SO28W
JP1: PINHD-1X8-3.5MM; 1X08-3.5MM
JP5, JP6: PINHD-1X8BIG; 1X08-BIG
JP7, JP8: PINHD-1X1; 1X01
JP9: GND; 1X01
Q1, Q2: BSS138; SOT23-3
R1, R8: 10K; M1206
R2, R3, R4: 330; M1206
R5: 4.7K; M1206
R6, R7: 1K; M1206
R9: 10k; M1206
R10, R13, R19: 33K; M1206
R11, R12, R16, R18: 22K; M1206
R14: 22k; M1206
R15, R17: 33k; M1206
R20, R21, R22, R23: 10K; 1206
S1: Push Button; TACTILE_SWITCH_PTH_6.0MM
SERVO1, SERVO2, SERVO3: PINHD-1X3; 1X03
U1: FT232RL; SSOP28DB
U2: LMV358; SO08
U3: LMV324; SO14
U$1: DAUGHTERBOARDDAUGHTERBOARD; DAUGHTERBOARD
U$2: TM4C123GH6PM; LQFP
U$3: ADC128D818; ADC12_SD
Y1: 16MHz; HC49US
Y2: 32.768kHz; CRYSTAL-PTH-2X6-CYL

Connections:
BUZZER: U$1.71, U$1.71', U$2.19 (19-PA2/SSI0CLK)
DB4: U$1.26, U$1.26', U$2.43 (43-PD4/U6RX/USB0DM/WT4CCP0)
DB5: U$1.25, U$1.25', U$2.44 (44-PD5/U6TX/USB0DP/WT4CCP1)
DB6: U$1.27, U$1.27', U$2.53 (53-PD6/M0FAULT0/PHA0/U2RX/WT5CCP0)
DB7: U$1.28, U$1.28', U$2.10 (10-PD7/NMI/PHB0/U2TX/WT5CCP1)
EN: U$1.24, U$1.24', U$2.30 (30-PF2/M0FAULT0/M1PWM6/SSI1CLK/TRDO)
EXTSHARP: R18.1, R19.1, U$3.11 (IN5)
FDSFSDF: R12.2, U3.1 (OUT), U3.2 (-IN)
GND: C1.2, C2.2, C3.2, C4.2, C5.2, C6.1, C7.2, C8.2, C9.2, C10.2, C11.2, C12.2, C13.2, C14.2, C15.2, C18.2, C19.2, C20.2, D1.C, D2.C, D3.C, GND.1, IC1.1 (GND), IC2.2 (GND), IC3.10 (VSS), IC3.15 (A0), IC3.16 (A1), IC3.17 (A2), JP1.4, JP9.1, R6.2, R7.2, R10.2, R13.2, R15.2, R17.2, R19.2, S1.3 (2), SERVO1.3, SERVO2.3, SERVO3.3, U1.7 (GND1), U1.18 (GND2), U1.21 (GND3), U1.25 (AGND), U1.26 (TEST), U2.4 (P$V-), U3.11 (P$V-), U$1.3, U$1.3', U$1.23, U$1.23', U$2.3 (3-GNDA), U$2.12 (12-GND), U$2.27 (27-GND), U$2.39 (39-GND), U$2.55 (55-GND), U$3.4 (GND)
GNDX: C16.2, C17.1, U$2.35 (35-GNDX)
HGHJ: R11.2, U2.1 (OUT), U2.2 (-IN)
INTAB: IC3.19 (INTB), IC3.20 (INTA), U$2.29 (29-PF1/CL0/M1PWM5/PHB0/SSI1TX/T0CCP1/TR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)
IR8: U$1.2, U$1.2', U$3.16 (IN0)
LPE: Q1.3 (D), R21.2, U$1.62, U$1.62'
unnamed: U$1.1, U$1.1'
unnamed: IC3.21 (GPA0), JP5.1
unnamed: C6.2, U$2.40 (40-OSC0), Y1.2
unnamed: IC3.22 (GPA1), JP5.2
unnamed: U2.6 (-IN), U2.7 (OUT)
unnamed: U$1.70, U$1.70', U$3.9 (IN7)
unnamed: IC3.23 (GPA2), JP5.3
unnamed: IC3.24 (GPA3), JP5.4
unnamed: IC3.25 (GPA4), JP5.5
unnamed: JP1.8, U$2.52 (52-PC0/SWCLK/T4CCP0/TCK)
unnamed: U$1.74, U$1.74'
unnamed: U$1.73, U$1.73'
unnamed: R18.2, U3.13 (-IN), U3.14 (OUT)
unnamed: JP1.7, U$2.51 (51-PC1/SWDIO/T4CCP1/TMS)
unnamed: U$1.69, U$1.69', U$3.10 (IN6)
unnamed: U$1.68, U$1.68'
unnamed: U$1.67, U$1.67'
unnamed: U$1.66, U$1.66'
unnamed: U$1.65, U$1.65'
unnamed: U$1.64, U$1.64'
unnamed: R6.1, U$3.7 (A0)
unnamed: IC3.26 (GPA5), JP5.6
unnamed: U$1.61, U$1.61'
unnamed: JP1.6, U$2.50 (50-PC2/T5CCP0/TDI)
unnamed: D1.A, R2.2
unnamed: C17.2, U$2.34 (34-XOSC0), Y2.1
unnamed: C16.1, U$2.36 (36-XOSC1), Y2.2
unnamed: U$1.18, U$1.18'
unnamed: U$1.19, U$1.19'
unnamed: JP1.5, U$2.49 (49-PC3/SWO/T5CCP1/TDO)
unnamed: IC3.27 (GPA6), JP5.7
unnamed: IC3.28 (GPA7), JP5.8
unnamed: IC3.1 (GPB0), JP6.1
unnamed: IC3.2 (GPB1), JP6.2
unnamed: IC3.3 (GPB2), JP6.3
unnamed: IC3.4 (GPB3), JP6.4
unnamed: IC3.5 (GPB4), JP6.5
unnamed: IC3.6 (GPB5), JP6.6
unnamed: IC3.7 (GPB6), JP6.7
unnamed: IC3.8 (GPB7), JP6.8
unnamed: U$1.33, U$1.33'
unnamed: U$1.34, U$1.34'
unnamed: U$1.40, U$1.40'
unnamed: U$1.47, U$1.47'
unnamed: U$1.48, U$1.48'
unnamed: U$1.49, U$1.49'
unnamed: R4.1, U1.22 (RXLED)
unnamed: R3.2, U1.23 (TXLED)
unnamed: D3.A, R4.2
unnamed: D2.A, R3.1
unnamed: R5.2, U$3.6 (INT)
unnamed: R7.1, U$3.8 (A1)
unnamed: C20.1, U1.4 (VCCIO), U1.17 (3V3OUT)
NO: C15.1, U$2.41 (41-OSC1), Y1.1
PA3: Q1.2 (S), R20.2, U$2.20 (20-PA3/SSI0FSS)
PA4: Q2.2 (S), R22.2, U$2.21 (21-PA4/SSIORX)
PA5: U$1.55, U$1.55', U$2.22 (22-PA5/SSI0TX)
PA6: U$1.54, U$1.54', U$2.23 (23-PA6/I2C1SCL/M1PWM2)
PB0: U$1.51, U$1.51', U$2.45 (45-PB0/T2CCP0/U1RX/USB0ID)
PB1: U$1.52, U$1.52', U$2.46 (46-PB1/T2CCP1/U1TX/USB0VBUS)
PB4: R10.1, R11.1, U$2.58 (58-PB4/AIN10/CAN0RX/M0PWM2/SSI2CLK/T1CC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)
PB5: U$1.46, U$1.46', U$2.57 (57-PB5/AIN11/CAN0TX/M0PWM3/SSI2FSS/T1CC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)
PD3: R16.1, R17.1, U$2.64 (64-PD3/AIN4/IDX0/SSI1TX/SSI3TX/USB0PFLT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)
PE0: R12.1, R13.1, U$2.9 (9-PE0/AIN3/U7RX)
PE1: U$1.12, U$1.12', U$2.8 (8-PE1/AIN2/U7TX)
PE2: R14.1, R15.1, U$2.7 (7-PE2/AIN1)
PE3: U$1.16, U$1.16', U$2.6 (6-PE3/AIN0)
PE4: U$1.43, U$1.43', U$2.59 (59-PE4/AIN9/CAN0RX/I2C2SCL/MOPWM2/U5RX)
PE5: U$1.42, U$1.42', U$2.60 (60-PE5/AIN8/CAN0TX/I2C2SDA/M0PWM5/M1PWM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)
PF3: U$1.50, U$1.50', U$2.31 (31-PF3/CAN0TX/M1PWM7/SSI1FSS/T1CCP1/TRC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)
PF4: U$1.53, U$1.53', U$2.5 (5-PF4/IDX0/M1FAULT0/T2CCP0/USB0EPEN)
RPE: Q2.3 (D), R23.2, U$1.63, U$1.63'
RS: U$1.22, U$1.22', U$2.28 (28-PF0/C0O/CAN0RX/M1PWM4/NMI/PHA0/SSI1R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)
RST: C9.1, IC3.18 (!RESET), JP1.1, R1.2, S1.1, U$2.38 (38-RST)
RX: JP1.2, U$2.17 (17-PA0/CAN1RX/U0RX)
RXD: U1.1 (TXD), U$2.16 (16-PC4/C1-/IDX1/M0PWM6/U1RTS/U1RX/U4RX/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)
SCL: IC3.12 (SCL), JP7.1, R9.1, U$2.47 (47-PB2/I2C0SCL/T3CCP0), U$3.3 (SCL)
SDA: IC3.13 (SDA), JP8.1, R8.1, U$2.48 (48-PB3/I2C0SDA/T3CCP1), U$3.2 (SDA)
SDFSDFSD: R14.2, U3.8 (OUT), U3.9 (-IN)
SERVO1: SERVO1.1, U$2.1 (1-PB6/M0PWM0/SSI2RX/T0CCP0)
SERVO2: SERVO2.1, U$2.4 (4-PB7/M0PWM1/SSI2TX/T0CCP1)
SERVO3: SERVO3.1, U$2.24 (24-PA7/I2C1SDA/M1PWM3)
SHARP1: U3.3 (+IN), U$1.11, U$1.11'
SHARP2: U3.10 (+IN), U$1.15, U$1.15'
SHARP3: U3.5 (+IN), U$1.41, U$1.41'
SHARP4: U3.12 (+IN), U$1.44, U$1.44'
SHARP5: U2.3 (+IN), U$1.45, U$1.45'
TX: JP1.3, U$2.18 (18-PA1/CAN1TX/U0TX)
TXD: U1.5 (RXD), U$2.15 (15-PC5/C1+M0PWM7/PHA1/U1CTS/U1TX/U4TX/W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)
USB+: U1.15 (USBDP), U$1.4, U$1.4'
USB-: U1.16 (USBDM), U$1.5, U$1.5'
VBATTERY: C4.1, C18.1, IC1.3 (IN), IC2.1 (VI), U$1.29, U$1.29'
VDD: 3.3V.1, C5.1, C7.1, C8.1, C11.1, C12.1, C13.1, C14.1, IC1.2 (OUT), IC3.9 (VDD), Q1.1 (G), Q2.1 (G), R1.1, R2.1, R5.1, R8.2, R9.2, R20.1, R22.1, U$2.2 (2-VDDA), U$2.11 (11-VDD), U$2.26 (26-VDD), U$2.37 (37-VBAT), U$2.42 (42-VDD), U$2.54 (54-VDD), U$3.1 (VREF), U$3.5 (V+)
VDDC: C1.1, C2.1, C3.1, C10.1, U$2.25 (25-VDDC), U$2.56 (56-VDDC)
VSERVO: 5V.1, C19.1, IC2.3 (VO), R21.1, R23.1, SERVO1.2, SERVO2.2, SERVO3.2, U2.8 (P$V+), U3.4 (P$V+)
VUSB: U1.20 (VCC), U$1.6
WL1: U$1.30, U$1.30', U$2.63 (63-PD2/AIN5/M0FAULT0/SSI1RX/SSI3RX/USB0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)
WL2: U$1.31, U$1.31', U$2.62 (62-PD1/AIN6/I2C3SDA/M0PWM7/M1PWM1/SSI1F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)
WL3: U$1.32, U$1.32', U$2.61 (61-PD0/AIN7/I2C3SCL/M0PWM6/M1PWM0/SSI1C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)
WL4: U$1.36, U$1.36', U$3.15 (IN1)
WL5: U$1.37, U$1.37', U$3.14 (IN2)
WL6: U$1.38, U$1.38', U$3.13 (IN3)
WL7: U$1.39, U$1.39', U$3.12 (IN4)
XXVX: R16.2, U3.6 (-IN), U3.7 (OUT)
ZIGBEERX: U$1.13, U$1.13', U$2.13 (13-PC7/CO-/U3TX/USB0PFLT/WT1CCP1)
ZIGBEETX: U$1.14, U$1.14', U$2.14 (14-PC6/C0+/PHB1/U3RX/USB0EPEN/WT1CCP0)

Notes on the sheet:
TCK
TMS
TDI
TDO
RST
TXD
RXD
GND
