eYSIP-2017/eYSIP-2017_Development-of-Tiva-based-daughter-board-for-FireBird/Schematic/Version 1/uC/DBSchematics.brd

## EAGLE design Schematic/Version 1/uC/DBSchematics.brd (continued)

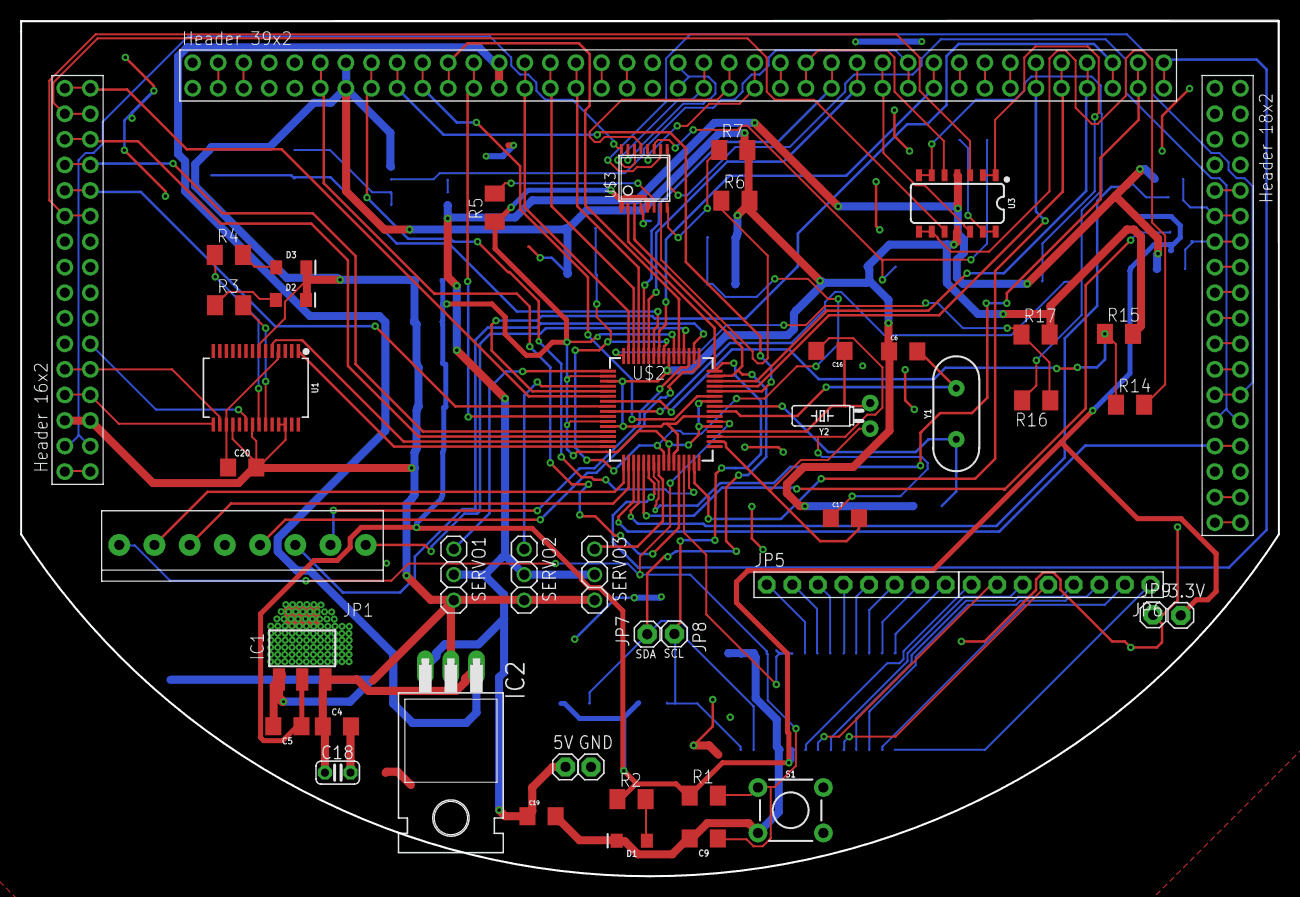
[picture p86: board DBSchematics.brd from above]

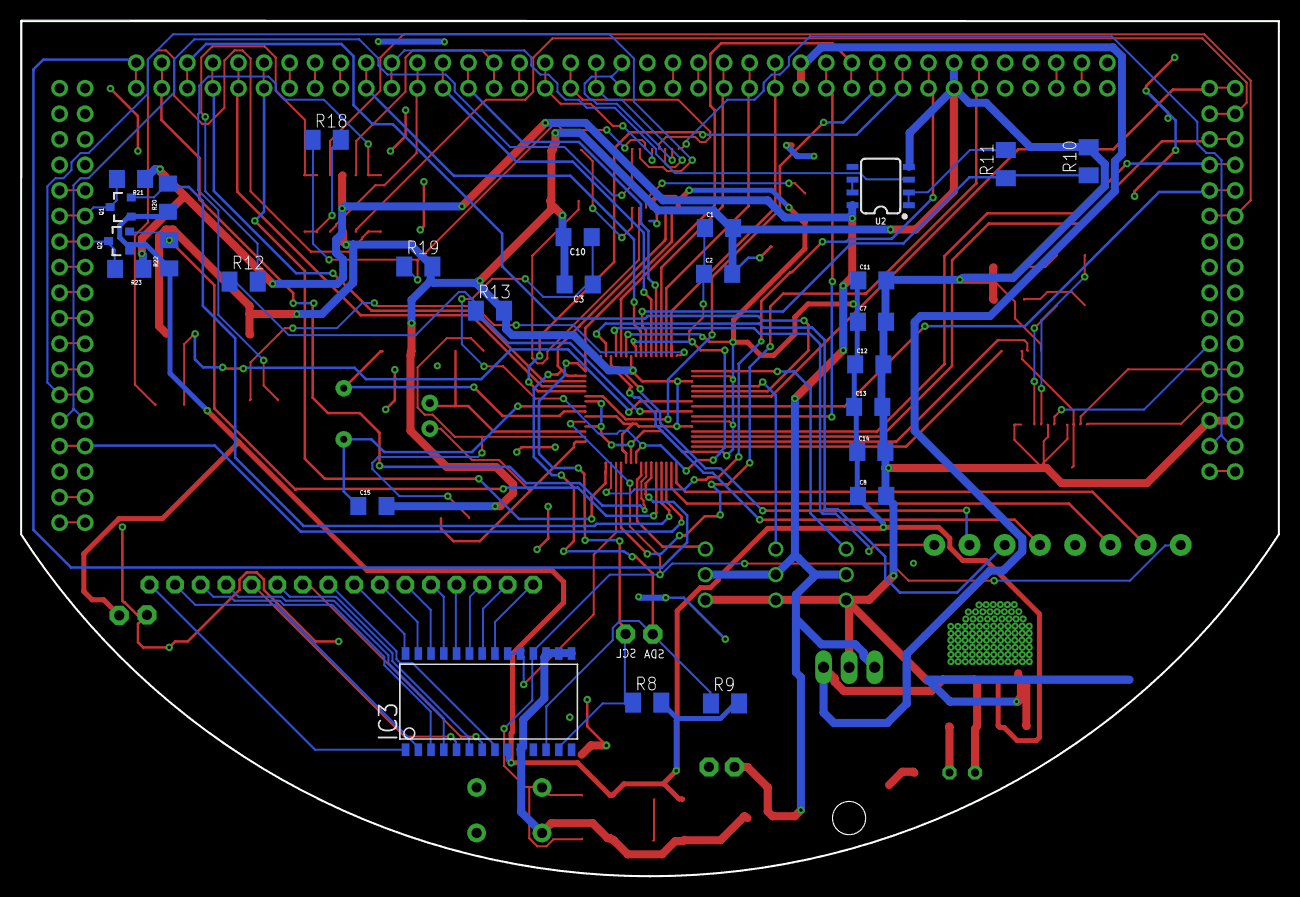
[picture p87: board DBSchematics.brd from below]

Board: 2 copper layers, 125.0 x 85.0 mm, 72 parts (27 on the bottom side), 120 nets.
