eYSIP-2017/eYSIP-2017_Development-of-Tiva-based-daughter-board-for-FireBird/(commit log)

2017-05-29 lcd Codes
    [FireBird Board Pin Out.xlsx]
2017-05-30 Daughter Board footprint library file
2017-05-30 Included Special Pins Of TM4C123Gh6PM in the sheet
    [FireBird Board Pin Out.xlsx]
2017-05-31 level converter using BJT
    [level_bjt.brd, level_bjt.sch]
2017-05-31 Wired And Wireless Serial Communication Achieved
2017-05-31 Level Convertor Schematics using Diodes
    [diode.brd, diode.sch]
2017-05-31 2 Way Wireless Communication
2017-05-31 ADC interfacing with IR
2017-05-31 ADC full project
2017-05-31 Started Schematics
    [DBSchematics.sch]
2017-05-31 Power Supply Updated
2017-06-01 Excel Sheet updated
    [DBSchematics.sch, FireBird Board Pin Out.xlsx]
2017-06-01 Work Continues
    [DBSchematics.sch]
2017-06-02 Schematic Almost Complete
    [DBSchematics.sch, FireBird Board Pin Out.xlsx, Logic_Level_Bidirectional.brd, Logic_Level_Bidirectional.sch]
2017-06-03 Pin details for schematic with pulgable TIVA board
    [schematic 2.xlsx]
2017-06-03 Schematic for Plugable daughter Board
    [Schematic-1.sch]
2017-06-05 Schematic updated
    [Schematic-1.sch]
2017-06-05 Schematic-2 Final
    [Schematic-1.sch]
2017-06-05 Progress Presentation I
    [DBSchematics.sch, FireBird Board Pin Out.xlsx]
2017-06-06 Final changes to Schematic 2
    [Schematic-1.sch]
2017-06-07 Port Expander Added
    [DBSchematics.sch]
2017-06-07 Layout of daughter board
    [Schematic-1.brd, Schematic-1.sch]
2017-06-08 Final schematic of TIVA Plugable Daughter Board on 8-6-2017
2017-06-08 Final tweaks to plugable Tiva board
    [Schematic-1.brd, Schematic-1.sch]
2017-06-09 uC based Board with manual Routing
    [DBSchematics.brd]
2017-06-09 Plugable TIVA board at 17:46
    [Schematic-1.brd, Schematic-1.sch]
2017-06-10 Interrupt of Port Expander Added
    [DBSchematics.brd]
2017-06-10 Plugable TIVA changes on 10-6-2017
    [Schematic-1.brd]
2017-06-10 Plugable Tiva board changes at 14:26 on 10-06-2017
    [Schematic-1.brd]
2017-06-12 Adding groung to layout of plugable TIVA board
    [Schematic-1.brd]
2017-06-13 Layout Complete
    [DBSchematics.brd, DBSchematics.sch]
2017-06-13 Manual Started
    [1 Level Convertor.sch, 5V Voltage Regulator For Servos.sch, FT2323 USB to Serial.sch, Port Expander Using I2C.sch]
2017-06-13 Plugable TIVA changes on 13-06-17
    [Schematic-1.brd, Schematic-1.sch]
2017-06-14 Schematics for documentation
    [External ADC.sch, Power Switch.sch, Servo Header.sch, To do list.xlsx, Voltage Divider.sch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]
2017-06-14 Schematics for manual
    [DBSchematics.sch, External ADC.sch, I2C header for uC.sch, I2C header.sch, Pin out of plug and play board.xlsx, Plug and play baord.sch, Port Expander for Plug and Play.sch, Power supply(3.3V).sch]
2017-06-16 Manual Updated
    [DBSchematics.brd]
2017-06-16 updated To Do list
    [To do list.xlsx]
2017-06-16 Powering and reset switch circuit added to manual
    [5V Voltage Regulator For Servos.sch, LCD.sch, Power supply(3.3V).sch]
2017-06-16 Schematic of LCD for manual
    [To do list.xlsx, schematic 2.xlsx]
2017-06-17 Updated Hardware manual and Sensor list
    [Sensor List.xlsx]
2017-06-17 PWM code
    [Sensor List.xlsx]
2017-06-19 Codes for velocity control
    [FireBird Board Pin Out.xlsx]
2017-06-19 Servo motor interfacing code. This code is not tested due to unavailabiity of servo motors
2017-06-19 Timer interrupt Overflow code
2017-06-23 sample commit
2017-06-23 Documented Timer overflow code, ADC code
2017-06-23 Documented code for ADC
2017-06-23 LCD and ADC code for uC based board
2017-06-26 Software Manual
    [Sensor List.xlsx]
2017-06-27 TIVA based Daughter Manual Board First Draft
    [Sensor List.xlsx]
2017-06-28 Servo code working
2017-06-28 Sharp sensor Interfaced
2017-06-29 Line Follower code and Updated Daughter Board Manual
2017-07-04 Version 2 of Plug and Play Board
    [Schematic-1.brd, Schematic-1.sch]
