eYSIP-2017/eYSIP-2017_Development-of-Tiva-based-daughter-board-for-FireBird/(notices)

Notices in the files:
parts and their libraries:
SparkFun-IC-Amplifiers: Licensing: Creative Commons ShareAlike 4.0 International - https://creativecommons.org/licenses/by-sa/4.0
